vishalcoelho/thesis_ultrasonic_localization/README.md

# Ultrasonic Localization



:no_entry: ARCHIVED :no_entry:

This is my M.S.E.E Thesis on Localization of UAV/UGVs in Urban Environments.
