vishalcoelho/thesis_ultrasonic_localization/(list of files, drawings)

Other design files:
hw/ultrasonic_localization/Analog_Signal_Conditioning.SchDoc
hw/ultrasonic_localization/Comp.SchLib
hw/ultrasonic_localization/Extra/Comp.SchLib
hw/ultrasonic_localization/Extra/Footprints.PcbLib
hw/ultrasonic_localization/Extra/GPS/GPS.PcbDoc
hw/ultrasonic_localization/Extra/Sonar/Sonar.PcbDoc
hw/ultrasonic_localization/Extra/Sonar/Sonar.PrjPCB
hw/ultrasonic_localization/Extra/Sonar/Sonar.SchDoc
hw/ultrasonic_localization/Localisation_board.PrjPCB
hw/ultrasonic_localization/New_Comp.SchLib
hw/ultrasonic_localization/New_Footprints.PcbLib
hw/ultrasonic_localization/Radio_Module.SchDoc
hw/ultrasonic_localization/SerialComm.SchDoc
hw/ultrasonic_localization/Ultrasonic_Localisation.PcbDoc
hw/ultrasonic_localization/Ultrasonic_Localisation.SchDoc
hw/ultrasonic_localization/Ultrasonic_Localisation_backup.PcbDoc
hw/ultrasonic_localization/Ultrasonic_Localisation_backup_v1.PcbDoc
hw/ultrasonic_localization/Ultrasonic_Localisation_new.PcbDoc
